manasXP/epicura/docs/02-Hardware/02-Technical-Specifications.md

---
created: 2026-02-15
modified: 2026-02-20
version: 5.0
status: Draft
---

# Technical Specifications

## 1. Heating System

### 1.1 Induction Heater (Microwave Surface Module)

The primary cooking element is a commercial microwave induction surface — a self-contained module with its own power coil, driver electronics, and AC power stage. The module handles all high-voltage power electronics internally and exposes a CAN bus interface for external control. This eliminates the need for custom IGBT driver circuits.

- **Rated Power:** 1,800W maximum
- **AC Input:** 220-240V, 50Hz single-phase (standard Indian household outlet) — connected directly to module
- **Coil Diameter:** 180-220mm (matched to pot base, internal to module)
- **Temperature Range:** 60-250C surface temperature
- **Control:** PID loop at 10Hz on STM32, power commands sent via CAN bus to module
- **Control Interface:** CAN 2.0B at 500 kbps (STM32 FDCAN1)
- **Pot Detection:** Internal to module (won't heat without compatible pot)
- **Internal Safety:** Pot detection, thermal cutoff, overcurrent protection (all module-internal)

### 1.2 Power Level Profiles

| Profile | Power (W) | Temp Range (C) | Use Case | Duty Cycle |
|---|---|---|---|---|
| **Sear** | 1,800 | 200-250 | Browning onions, tempering spices | 100% |
| **Boil** | 1,500 | 100 | Bringing water/gravy to boil | 85% |
| **Simmer** | 400-600 | 80-95 | Slow cooking dal, curry reduction | 25-35% |
| **Warm** | 200 | 60-70 | Keep-warm after cooking complete | 10-15% |
| **Off** | 0 | Ambient | Idle, cool-down | 0% |

### 1.3 PID Control Parameters

- **Setpoint Source:** Recipe state machine (via CM5 command)
- **Feedback:** IR thermometer (primary), CAN coil temperature (secondary/safety)
- **Loop Rate:** 10Hz (100ms period)
- **Output:** Power level command (0-100%) via CAN bus to microwave surface module
- **Overshoot Protection:** Maximum 10C above setpoint triggers power reduction
- **Safety Cutoff:** CAN coil over-temp or IR >270C triggers immediate shutdown

## 2. Sensor Specifications

### 2.1 Camera Module

| Parameter | Value |
|---|---|
| Module | IMX219 (standard) or IMX477 (HQ option) |
| Resolution | 1920x1080 at 30fps (1080p) |
| Interface | MIPI CSI-2 (2-lane) to CM5 |
| Sensor Size | 1/4" (IMX219) or 1/2.3" (IMX477) |
| Field of View | 62.2 (IMX219) or adjustable C/CS mount (IMX477) |
| White Balance | Auto white balance with LED ring compensation |
| Illumination | WS2812B LED ring (12-16 LEDs) or white LED ring with diffuser |
| Mounting | Overhead gantry, 20-30cm above pot center |
| Purpose | Food color/texture analysis, stage detection via CV |

### 2.2 IR Thermometer

| Parameter | Value |
|---|---|
| Part | MLX90614ESF-BAA (medical/food grade) |
| Type | Non-contact infrared thermopile |
| Interface | I2C (address 0x5A default), connected to STM32 |
| Object Temp Range | -70C to +380C |
| Accuracy | +/-0.5C (0-50C ambient), +/-1.0C (full range) |
| Field of View | 90 (wide FOV variant) |
| Resolution | 0.02C |
| Supply Voltage | 3.3V |
| Mounting | Angled toward pot center, 5-10cm distance |
| Purpose | Food surface temperature, PID feedback |

## 3. Data Storage

### 3.1 Storage Architecture

| Storage | Medium | Capacity | Purpose |
|---|---|---|---|
| **eMMC** | On-board CM5 carrier | 8-16 GB | OS, application, recipe DB, cooking logs |
| **SD Card** | MicroSD slot on CM5 | 16-64 GB (optional) | Recipe backup, logs archive, user media |
| **RAM** | LPDDR4 on CM5 | 4-8 GB | Runtime, CV inference, UI frame buffer |

### 3.2 Recipe Database

- **Format:** JSON or YAML per recipe file
- **Recipe Count:** 100+ initial, expandable via OTA
- **Size per Recipe:** ~30-50 KB (steps, temps, timings, images)
- **Total DB Size:** ~5-10 MB initial
- **Storage:** SQLite index + individual recipe files on eMMC
- **Sync:** Cloud download to local, offline fallback guaranteed

### 3.3 Cooking Logs

- **Format:** SQLite database
- **Fields:** Timestamp, recipe ID, step transitions, temperatures (IR + CAN coil), weights, durations, errors, user feedback
- **Retention:** Last 500 cook sessions (~50 MB)
- **Export:** JSON via app or USB

### 3.4 User Preferences

- **Format:** JSON configuration file
- **Contents:** Spice levels, allergens, dietary restrictions, portion sizes, WiFi credentials
- **Backup:** Synced to cloud account when connected

## 4. Power Specifications

| Parameter | Specification |
|---|---|
| **AC Input** | 220-240V, 50Hz, single-phase |
| **Maximum Draw** | <2,000W (1,800W induction + 75W system) |
| **Fuse Rating** | 10A (IEC C14 inlet with integrated fuse) |
| **PSU** | Mean Well LRS-75-24 (24V / 3.2A / 76.8W) |
| **24V Rail** | 24V / 3.2A — main bus from PSU; feeds actuators (12V, 6.5V rails), induction CAN control, safety relay |
| **12V UPS Input** | 12V DC from off-the-shelf UPS — feeds TPS54531 12V→5V 5A buck on Driver PCB |
| **5V Rail** | 5V — three-source Schottky-OR: 5V_MAIN (TPS54531, UPS-backed), 5V_USB (USB-C VBUS), 5V_BATT (MT3608 boost from Li-Ion) → 5V_MERGED → AMS1117 → 3.3V |
| **USB-C Power** | 5V from USB-C VBUS via 500mA polyfuse — enables standalone programming/debug without 24V PSU |
| **Li-Ion Battery** | Single-cell 3.7V Li-Ion (JST-PH 2-pin) — TP4056 CC/CV charger (500mA) + DW01A/FS8205A protection + MT3608 boost to 5V — micro-UPS for STM32 RTC/state retention |
| **3.3V Rail** | 3.3V / 500mA (LDO from 5V_MERGED on Unified PCB) — STM32, sensors, I2C devices |
| **Standby Power** | <5W (CM5 idle, display off, induction off) |
| **PSU Type** | Mean Well enclosed AC-DC, single 24V output |
| **Efficiency** | >87% at full load (Mean Well LRS-75 series) |

### 4.1 12V UPS Recommended Specifications

An off-the-shelf 12V UPS powers the 5V rail (CM5 + STM32) independently of the 24V PSU, allowing the system to detect AC power loss, save cooking state, and gracefully pause.

| Parameter | Minimum | Recommended | Notes |
|---|---|---|---|
| Output Voltage | 12V DC | 12V DC (regulated) | Must be within TPS54531 input range (3.5-28V) |
| Output Current | 3A | 5A | 5V rail peak is ~4A; headroom for inrush |
| Battery Capacity | 7Ah (84Wh) | 9Ah (108Wh) | At ~20W load (CM5 + STM32 + display), 7Ah gives ~25 min runtime |
| Battery Type | Sealed lead-acid (SLA) | Lithium iron phosphate (LiFePO4) | LiFePO4: lighter, longer cycle life, flat discharge curve |
| Charging | Integrated (AC mains) | Integrated with auto-switchover | UPS charges from AC; switches to battery on AC loss |
| Switchover Time | <20ms | <10ms | Must be faster than CM5's hold-up (bulk caps provide ~50ms) |
| Output Connector | Bare wire or barrel jack | XT30 (to match J_12V_UPS) | Adapter cable may be needed |
| Form Factor | — | Compact, <2kg | Must fit inside or adjacent to Epicura enclosure |

**Example products:** Mini DC UPS modules (e.g., "12V 5A UPS module" on AliExpress/Amazon, ~$15-30) that accept 12V AC adapter input, contain a LiFePO4 or Li-ion battery pack, and provide uninterrupted 12V output with automatic switchover.

> [!tip]
> During AC power failure, only the 5V rail (CM5 + STM32 + display) remains powered. The 24V rail (actuators, induction) goes down immediately. The STM32 detects 24V loss via COMP1 comparator (<100µs), disables all actuators, and notifies the CM5 to save state. At ~20W idle draw, a 7Ah 12V battery provides approximately 25 minutes — enough time to save state and wait for power restoration. If power returns within 5 minutes, cooking auto-resumes; otherwise the user is prompted.

### 4.2 Power Budget Breakdown

| Subsystem | Typical (W) | Peak (W) |
|---|---|---|
| Induction heater | 600 | 1,800 |
| CM5 + camera + display | 15 | 25 |
| STM32 + sensors | 2 | 3 |
| BLDC stirring motor | 12 | 48 |
| P-ASD pump + solenoids | 1 | 10 |
| CID-1 stepper driver (24V) | 0 | 72 |
| CID-2 linear actuator (12V) | 0 | 2.5 |
| SLD pumps (x2) + solenoids (x2) | 0 | 16 |
| LED ring | 2 | 5 |
| Exhaust fan | 1 | 3 |
| PSU losses | 10 | 30 |
| **Total** | **644** | **1,927** |

## 5. Performance Requirements

| Parameter | Target | Notes |
|---|---|---|
| CV Inference Latency | <500ms | Food stage classification per frame |
| PID Control Loop | 10Hz (100ms) | Temperature regulation on STM32 |
| Motor Control Loop | 50Hz (20ms) | Servo position updates on STM32 |
| UI Response Time | <200ms | Touch-to-visual feedback on display |
| System Boot Time | <30s | Power-on to recipe selection screen |
| Temperature Accuracy | +/-5C | IR sensor to actual food surface |
| Dispensing Accuracy | ~±20% (P-ASD), ±5% (SLD) | P-ASD by pressure-and-time (ADS1015 feedback), SLD by dedicated per-reservoir load cells (2× 2 kg) |
| Camera Latency | <100ms | Capture to frame available in memory |
| Recipe Step Transition | <2s | From stage detection to actuator response |
| WiFi Connection | <10s | Auto-reconnect to saved network |
| OTA Update | <5 min | Full recipe DB refresh over WiFi |

## 6. Communication Interfaces

| Interface | Protocol | Speed | Endpoints | Purpose |
|---|---|---|---|---|
| CM5 <-> STM32 | UART (primary) | 115200 baud | CM5 UART0 <-> STM32 USART1 | Commands, telemetry, heartbeat |
| CM5 <-> STM32 | CAN (alternative) | 500 kbps | CM5 SPI-CAN <-> STM32 CAN1 | Higher reliability option |
| CM5 <-> Camera | MIPI CSI-2 | 2-lane | CM5 CSI port <-> IMX219/477 | Video frames for CV |
| CM5 <-> Display | DSI or HDMI | 1080p/60Hz | CM5 DSI/HDMI <-> 10" panel | UI rendering |
| CM5 <-> Touch | I2C | 400 kHz | CM5 I2C1 <-> touch controller | Touch input events |
| STM32 <-> IR Sensor | I2C | 100 kHz | STM32 I2C1 <-> MLX90614 | Temperature readings |
| STM32 <-> SLD Load Cells | SPI-like GPIO | 10 Hz | STM32 GPIO <-> 2× HX711 | SLD reservoir weight measurements |
| STM32 <-> BLDC Motor | PWM + GPIO | 10 kHz + digital | STM32 TIM1_CH1 (PA8) + PA4 (EN) + PA5 (DIR) | Stirring motor speed, enable, direction |
| STM32 <-> Microwave Surface | CAN 2.0B | 500 kbps | STM32 FDCAN1 (PB8/PB9) via J_STACK → Driver PCB ISO1050DUB → J_CAN <-> module CAN port | Induction power control via CAN; 5 kV isolation on Driver PCB |
| STM32 <-> Exhaust Fan | PWM | 25 kHz | STM32 TIM4 CH3 <-> fan 4-pin | Fume extraction speed |
| CM5 <-> WiFi | 802.11ac | Up to 867 Mbps | Onboard CM5 radio | App, cloud, OTA |
| CM5 <-> BT | BLE 5.0 | 2 Mbps | Onboard CM5 radio | Initial app pairing, proximity |

## 7. Related Documentation

- [[01-Epicura-Architecture|Hardware Architecture & Wiring Diagrams]]
- [[03-Sensors-Acquisition|Sensors & Data Acquisition]]
- [[04-Mechanical-Design|Mechanical Design]]
- [[../05-Subsystems/05-Exhaust-Fume-Management|Exhaust & Fume Management]]
- [[__Workspaces/Epicura/docs/01-Overview/01-Project-Overview|Project Overview]]

#epicura #technical-specifications #hardware

---

## 8. Revision History

| Version | Date | Author | Changes |
|---|---|---|---|
| 1.0 | 2026-02-15 | Manas Pradhan | Initial document creation |
| 2.0 | 2026-02-16 | Manas Pradhan | Update power budget and dispensing accuracy for P-ASD pneumatic redesign |
| 3.0 | 2026-02-20 | Manas Pradhan | Updated CAN interface row: transceiver (ISO1050DUB) now on Driver PCB, FDCAN1 signals route via J_STACK pins 19-20 |
| 5.0 | 2026-03-09 | Manas Pradhan | Updated power specifications for 3-source 5V architecture (USB-C + Li-Ion battery + UPS), added USB-C and battery power entries |
| 4.0 | 2026-02-20 | Manas Pradhan | Replaced DS3225 servo with 24V BLDC motor in communication interfaces and power budget; servo PWM row → BLDC PWM+EN+DIR row |
