manasXP/epicura/docs/05-Subsystems/03-Ingredient-Dispensing.md

---
created: 2026-02-15
modified: 2026-03-11
version: 6.0
status: Draft
---

# Ingredient Dispensing System

## 1. Overview

The ingredient dispensing system is divided into three purpose-built subsystems, each optimized for a different ingredient class. Together they surround the cooking pot and are orchestrated by the STM32 controller under commands from the CM5 recipe engine.

| Subsystem | Full Name | Purpose | Actuators | Metering |
|---|---|---|---|---|
| **P-ASD** | Pneumatic Advanced Seasoning Dispenser | Ground/powdered spices (turmeric, chili, cumin, salt, garam masala, coriander) | 6 Solenoid Valves + Micro Diaphragm Pump | Pressure-and-time-based (ADS1015 feedback) |
| **CID** | Coarse Ingredients Dispenser | Pre-cut vegetables, meat, paneer, dal, rice | CID-1: NEMA 23 stepper + ext. driver; CID-2: DC linear actuator (slider mechanism) | Timed/position-based |
| **SLD** | Standard Liquid Dispenser | Oil and water | 2 Peristaltic Pumps + 2 Solenoid Valves + 2 Load Cells (one per reservoir) | Closed-loop weight feedback + low-level alerts |

## 2. Layout

### 2.1 Top-View Arrangement

```
┌───────────────────────────────────────────────────────┐
│                    REAR OF UNIT                        │
│                                                        │
│       ┌──────────────────────────────────────────┐     │
│       │        P-ASD (Pneumatic Seasonings)       │     │
│       │  ┌────────┐ ┌────────┐ ┌────────┐        │     │
│       │  │P-ASD-1 │ │P-ASD-2 │ │P-ASD-3 │ Row A  │     │
│       │  │Turmeric│ │ Chili  │ │ Cumin  │ (rear) │     │
│       │  │(60 mL) │ │(60 mL) │ │(60 mL) │        │     │
│       │  └───┬────┘ └───┬────┘ └───┬────┘        │     │
│       │  ┌───┴────┐ ┌───┴────┐ ┌───┴────┐        │     │
│       │  │P-ASD-4 │ │P-ASD-5 │ │P-ASD-6 │ Row B  │     │
│       │  │  Salt  │ │ Garam  │ │Coriand.│ (front)│     │
│       │  │(60 mL) │ │ Masala │ │(60 mL) │        │     │
│       │  └───┬────┘ └───┬────┘ └───┬────┘        │     │
│       └──────┼──────────┼──────────┼──────────────┘     │
│              ▼          ▼          ▼                    │
│  ┌─────┐ ┌──────────────────────────────────┐ ┌─────┐ │
│  │ SLD │ │                                  │ │ SLD │ │
│  │Oil  │ │          COOKING POT             │ │Water│ │
│  │Pump │►│          (Center)                │◄│Pump │ │
│  │     │ │                                  │ │     │ │
│  └─────┘ └──────────────────────────────────┘ └─────┘ │
│              ▲                       ▲                  │
│       ┌──────┴───────────────────────┴─────────┐       │
│       │           CID (Coarse)                 │       │
│       │  ┌──────────────┐  ┌──────────────┐    │       │
│       │  │    CID-1     │  │    CID-2     │    │       │
│       │  │  Vegetables  │  │  Dal / Rice  │    │       │
│       │  │ / Meat (400mL│  │  / Paneer    │    │       │
│       │  │  tray)       │  │  (400mL tray)│    │       │
│       │  └──────────────┘  └──────────────┘    │       │
│       └────────────────────────────────────────┘       │
│                    FRONT OF UNIT                        │
└───────────────────────────────────────────────────────┘
```

### 2.2 Side-View Cross Sections

**P-ASD (Pneumatic Puff-Dosing):**

```
              ┌──── Threaded cap + silicone O-ring seal
              │     ┌── Desiccant pocket (1g silica gel)
              ▼     ▼
       ┌───────────────────┐
       │  ╔═══════════════╗│
       │  ║               ║│  45 mm dia × 50 mm tall
       │  ║   SPICE       ║│  60 mL capacity
       │  ║   POWDER      ║│  Food-grade PP, translucent
       │  ║               ║│
       │  ╚═══╤═══════╤═══╝│
       │      │  AIR ► │    │ ◄── Air inlet barb (4mm, side wall)
       │      └───┬───┘    │
       │     ┌────▼────┐   │
       │     │ 5mm     │   │ ◄── Discharge orifice + 200-mesh SS screen
       │     │ orifice │   │
       │     └────┬────┘   │
       └──────────┼────────┘
                  │
           ┌──────▼──────┐
           │  Bayonet    │ ◄── Quarter-turn lock into docking station
           │  collar     │
           └──────┬──────┘
                  │
           ┌──────▼──────┐
           │ Chute /     │ ◄── Shared collection funnel
           │ Funnel      │
           └──────┬──────┘
                  ▼
       ┌────────────────────┐
       │    COOKING POT     │
       └────────────────────┘
```

**CID (Stepper/Linear Actuator Slider):**

```
       ┌──────────────────────────────────────┐
       │          TRAY (removable)            │
       │  ┌──────────────────────────┐        │
       │  │  Pre-cut ingredients     │  PUSH  │
       │  │  (vegetables, dal, etc.) │◄──PLATE│
       │  └──────────────┬───────────┘   │    │
       │                 │               │    │
       │                 ▼             ──┤    │
       │           ┌──────────┐     Linear    │
       │           │  Drop-off│     Actuator  │
       │           │  Edge    │     (12V DC)  │
       │           └─────┬────┘               │
       └─────────────────┼────────────────────┘
                         ▼
                ┌────────────────────┐
                │    COOKING POT     │
                └────────────────────┘
```

**SLD (Peristaltic Pump + Solenoid):**

```
    ┌──────────────┐
    │  Reservoir   │
    │  (Oil/Water) │
    │  500 mL      │
    └──────┬───────┘
           │ Silicone tube (6mm ID)
           ▼
    ┌──────────────┐
    │  Peristaltic │ ◄── 12V DC gear motor, PWM speed control
    │  Pump        │     Flow rate: 5-50 mL/min
    └──────┬───────┘
           │
           ▼
    ┌──────────────┐
    │  Solenoid    │ ◄── 12V NC solenoid, prevents drip when idle
    │  Valve       │
    └──────┬───────┘
           │
           ▼
    ┌──────────────┐
    │  Nozzle      │ ──► Into cooking pot
    └──────────────┘

    ┌──────────────┐  ┌──────────────┐
    │  Load Cell   │  │  Load Cell   │ ◄── 2× dedicated HX711 (one per reservoir)
    │  (under oil  │  │  (under water│     Closed-loop: pump until target Δweight
    │   reservoir) │  │   reservoir) │     Low-level alert when < threshold
    └──────────────┘  └──────────────┘
```

## 3. P-ASD — Pneumatic Advanced Seasoning Dispenser

### 3.1 Mechanism Overview

The P-ASD uses **puff-dosing** — a micro diaphragm pump pressurizes a small accumulator to ~1.0 bar. Individual solenoid valves open briefly (100–400 ms), delivering calibrated air bursts into sealed cartridges. The pressure forces powder through a 5 mm bottom orifice into a shared funnel chute leading to the pot. This eliminates all moving parts from the powder path, dramatically improving reliability with sticky Indian spices like turmeric and chili.

### 3.2 Cartridge Specifications

| Parameter | Value |
|---|---|
| Cartridges | 6 (P-ASD-1 through P-ASD-6) |
| Capacity | 60 mL each |
| Dimensions | 45 mm diameter × 50 mm tall (cylindrical) |
| Material | Food-grade polypropylene (PP), translucent |
| Removable | Yes (quarter-turn bayonet lock for quick swap) |
| Lid | Threaded screw-cap with silicone O-ring seal, desiccant pocket |
| Orifice | 5 mm diameter bottom opening with 200-mesh SS anti-clog screen |
| Air Inlet | 4 mm barb on side wall (above powder line), self-sealing push-fit |
| Weight (empty) | ~25 g |

### 3.3 Default Cartridge Assignment

| Cartridge | Position | Default Spice |
|---|---|---|
| P-ASD-1 | Row A, Left | Turmeric powder |
| P-ASD-2 | Row A, Center | Chili powder |
| P-ASD-3 | Row A, Right | Cumin powder |
| P-ASD-4 | Row B, Left | Salt (fine) |
| P-ASD-5 | Row B, Center | Garam masala |
| P-ASD-6 | Row B, Right | Coriander powder |

### 3.4 Pneumatic System

#### 3.4.1 Air Source

| Parameter | Value |
|---|---|
| Type | 12V micro diaphragm pump (e.g., SC3701PM or equivalent) |
| Max Pressure | 2.0 bar (200 kPa) |
| Free Flow | 3–4 L/min |
| Voltage | 12V DC |
| Current | 0.5–0.8 A |
| Noise | <45 dB |
| Size | 65 × 40 × 40 mm |

#### 3.4.2 Accumulator & Regulation

| Component | Specification |
|---|---|
| Accumulator | 100 mL sealed aluminum cylinder, 1.5 bar max |
| Pressure Regulator | Miniature inline, adjustable 0.3–2.0 bar |
| Pressure Sensor | ADS1015 (I2C) + MPXV5100GP analog, on I2C1 bus (address 0x48) |
| Relief Valve | 2.0 bar pop-off safety valve on accumulator |
| Operating Pressure | 0.8–1.2 bar nominal |

#### 3.4.3 Solenoid Valves (×6)

| Parameter | Value |
|---|---|
| Type | 2-way normally-closed, direct-acting, 12V DC |
| Response Time | <20 ms open, <30 ms close |
| Orifice | 2–3 mm (sufficient for air burst) |
| Power | ~4W when energized (one at a time) |
| Driver | IRLML6344 N-MOSFET (SOT-23) with flyback diode on Driver PCB |
| Cost | ~$3.50 each |

#### 3.4.4 Pneumatic Circuit

```
12V ───► Micro Diaphragm Pump (3-4 L/min, <45 dB)
              │
              ▼
         Accumulator (100 mL, 1.5 bar max)
              │
              ▼
         Pressure Regulator (set 1.0 bar) + Relief Valve (2.0 bar)
              │
              ▼
         Pressure Sensor ──► STM32 via I2C1 (ADS1015 @ 0x48)
              │
              ▼
         ┌─── 6-Way Manifold (3D-printed nylon PA12) ───┐
         │                                               │
    ┌──┐ ┌──┐ ┌──┐ ┌──┐ ┌──┐ ┌──┐
    │V1│ │V2│ │V3│ │V4│ │V5│ │V6│   6× 12V NC solenoid valves
    └┬─┘ └┬─┘ └┬─┘ └┬─┘ └┬─┘ └┬─┘
     ▼    ▼    ▼    ▼    ▼    ▼
   C-1  C-2  C-3  C-4  C-5  C-6     Cartridges
```

### 3.5 Anti-Clog Design

Pneumatic dispensing inherently prevents clogging — the primary failure mode of gravity-fed systems:

| Advantage | Mechanism |
|---|---|
| Bridge breaking | Pressurized air shatters powder arches over the orifice |
| Humidity tolerance | Forced airflow pushes damp/sticky powder through |
| No residue buildup | No gate in powder path; orifice air-cleared after every dispense |
| Self-clearing nozzle | Post-dispense purge (200 ms at 1.2 bar) cleans orifice |
| 200-mesh SS screen | Prevents large clumps from blocking the 5 mm orifice |
| 60° cone angle | Internal cartridge geometry prevents dead zones |

**Clog Recovery (if no pressure drop after 3 pulses):** Rapid 50 ms on/off oscillating air pulses to vibrate powder loose — pneumatic equivalent of vibration motors, but with no additional hardware.

### 3.6 Metering Strategy

P-ASD uses **calibrated puff-dosing with pressure-drop verification**:

**Primary control:** Timed air pulses calibrated per spice type:

| Spice | Bulk Density (g/mL) | Pulse Duration for ~1g (ms) | Pressure (bar) |
|---|---|---|---|
| Turmeric powder | 0.55 | 200–300 | 1.0 |
| Chili powder | 0.45 | 250–350 | 1.0 |
| Cumin powder | 0.40 | 300–400 | 1.0 |
| Salt (fine) | 1.20 | 100–150 | 0.8 |
| Garam masala | 0.50 | 200–300 | 1.0 |
| Coriander powder | 0.35 | 300–400 | 1.0 |

**Secondary control (pressure-drop verification):** ADS1015 pressure sensor confirms powder ejection:

1. Record pre-dispense accumulator pressure via ADS1015 → P_initial
2. Pre-purge: 100 ms pulse at 0.3 bar (loosen packed powder)
3. Main dispense: open solenoid for calibrated duration
4. Read post-pulse pressure → P_final; verify pressure drop ≥ threshold (confirms air flowed through powder bed)
5. If pressure drop < threshold → additional 50 ms pulses (up to 3 retries)
6. Post-dispense purge: 200 ms at 1.2 bar (clear orifice)
7. Log estimated dispensed amount (pulse count × calibrated mass per pulse)

Accuracy: ~±20% of target weight (pressure-and-time-based, no direct weight feedback).

## 4. CID — Coarse Ingredients Dispenser

### 4.1 Tray Specifications

| Parameter | Value |
|---|---|
| Trays | 2 (CID-1, CID-2) |
| Capacity | 400 mL each (shallow tray, ~200×100×20 mm) |
| Material | Food-grade PP (removable, dishwasher-safe) |
| Removable | Yes (slide-out tray) |
| Ingredient Types | Pre-cut vegetables, meat, paneer, dal, rice |

### 4.2 Actuators

**CID-1: NEMA 23 Stepper Motor + External Driver**

| Parameter | Value |
|---|---|
| Motor | NEMA 23, 1.8°/step (200 steps/rev), ~2A/phase |
| Driver | External DM542/TB6600-class (pulse/dir/enable, 24V input) |
| Control | TIM1_CH3 (PA10) PUL+, GPIO (PB4) DIR+, PCF8574 P7 ENA+ — all via 100R series resistors |
| Position Feedback | Home limit switch only (PB6); step counting for travel distance |
| Supply | 24V from input rail via J_CID (2–3A to external driver) |
| Cost | ~$15 (motor) + ~$10 (driver) |

**CID-2: 12V DC Linear Actuator (unchanged)**

| Parameter | Value |
|---|---|
| Type | 12V DC linear actuator, 50 mm stroke |
| Force | 20–50 N (sufficient to push 500g of chopped vegetables) |
| Speed | ~10 mm/s |
| Control | H-bridge motor driver (DRV8876RGTR #2), EN/PH direction + PWM |
| Position Feedback | Limit switches at home and full-extend positions |
| Supply | 12V from PSU rail |
| Cost | ~$8 |

### 4.3 Dispensing Mechanism

The push-plate slides along the tray, sweeping ingredients off the drop-off edge into the pot:

1. CM5 sends CID dispense command with tray ID
2. STM32 drives actuator forward: CID-1 via stepper pulses (TIM1_CH3), CID-2 via DRV8876 PWM
3. Ingredients fall off tray edge into pot
4. CID-1: step count reaches travel target → reverse to home; CID-2: full-extend limit switch → retract to home
5. Dispense confirmed by home switch

### 4.4 Metering Strategy

CID uses **position-based / timed dispensing**:

- Full push = entire tray contents dumped at once (typical usage)
- Partial push = actuator extends to a specified position (for partial dispense)
- No closed-loop weight verification (coarse items are pre-measured by user when loading tray)

## 5. SLD — Standard Liquid Dispenser

### 5.1 Channel Specifications

| Parameter | Oil Channel (SLD-OIL) | Water Channel (SLD-WATER) |
|---|---|---|
| Reservoir | 200 mL food-grade PP bottle | 500 mL food-grade PP bottle |
| Tube | 6 mm ID food-grade silicone | 6 mm ID food-grade silicone |
| Pump | 12V DC peristaltic, 5–50 mL/min | 12V DC peristaltic, 5–50 mL/min |
| Valve | 12V NC solenoid (drip prevention) | 12V NC solenoid (drip prevention) |
| Nozzle | Directed into pot center | Directed into pot center |

### 5.2 Actuators

**Peristaltic Pump (×2):**

| Parameter | Value |
|---|---|
| Type | Peristaltic roller pump, 12V DC gear motor |
| Tube | Food-grade silicone, 6 mm ID |
| Flow Rate | 5–50 mL/min (adjustable via PWM motor speed) |
| Accuracy | ±2% volumetric (further refined by load cell) |
| Advantage | Self-priming, no contamination (fluid only touches tube), reversible |
| Cost | ~$10 each |

**Solenoid Valve (×2):**

| Parameter | Value |
|---|---|
| Type | 12V DC, normally closed, spring return |
| Response | <50 ms open/close |
| Purpose | Prevent dripping when pump is off |
| Power | ~5W when energized |
| Driver | N-channel MOSFET (IRLZ44N) with flyback diode |
| Cost | ~$4 each |

### 5.3 Dedicated Load Cells (2×)

| Parameter | Value |
|---|---|
| Type | 2× 2 kg strain gauge (one under each SLD reservoir: oil and water) |
| ADC | 2× dedicated HX711 |
| Purpose | Individual liquid level monitoring + closed-loop dispensing by tracking reservoir weight decrease |
| Capacity | 2 kg per load cell (accommodates full reservoir + container weight) |
| Accuracy | ±1 g (24-bit HX711 with averaging) |
| Sampling | 10 Hz |
| Low-Level Alert | Configurable threshold per channel (default: 50 g remaining); alert sent to CM5 + UI when level drops below threshold |
| Cost | ~$5 (load cell) × 2 + ~$3 (HX711) × 2 = ~$16 total |

### 5.4 Metering Strategy (Closed-Loop)

SLD uses **two dedicated load cells** (one under each reservoir) for independent closed-loop dispensing and level monitoring:

```
┌───────────────┐
│ 1. Tare       │
│ reservoir     │──► W_initial = sld_load_cell[channel].read()
│ weight        │
└───────┬───────┘
        │
        ▼
┌───────────────┐
│ 2. Open       │
│ solenoid +    │──► solenoid[channel].open()
│ start pump    │    pump[channel].start(speed)
└───────┬───────┘
        │
        ▼
┌───────────────┐
│ 3. Monitor    │
│ reservoir     │──► W_dispensed = W_initial - sld_load_cell[channel].read()
│ weight loss   │    (sampled at 10 Hz)
│ in real-time  │
└───────┬───────┘
        │
        ▼
┌───────────────┐
│ 4. Stop pump  │
│ + close       │──► IF W_dispensed >= target_g * 0.95:
│ solenoid when │        pump[channel].stop()
│ target reached│        solenoid[channel].close()
└───────┬───────┘
        │
        ▼
┌───────────────┐
│ 5. Verify     │
│ final weight  │──► W_actual = W_initial - sld_load_cell[channel].read()
│ and log       │    log(channel, target_g, W_actual)
│               │    IF sld_load_cell[channel].read() < LOW_LEVEL_THRESHOLD:
│               │        send SLD_LOW_LEVEL alert to CM5
└───────────────┘
```

Accuracy: ±5% of target weight (significantly better than ASD due to dedicated load cell and controllable flow rate).

## 6. STM32 Control Interface

### 6.1 GPIO and PWM Assignments

| Subsystem | Actuator | STM32 Pin | Interface | Notes |
|---|---|---|---|---|
| **P-ASD** | Diaphragm Pump Motor | PA0 (TIM2_CH1) | PWM | 12V pump speed control via MOSFET |
| **P-ASD** | Solenoid Valves V1-V6 | PCF8574 P0-P5 (I2C1, addr 0x20) | Digital output via MOSFET | 12V NC solenoids, cartridges 1-6; PCF8574 on Driver PCB |
| **P-ASD** | Pressure Sensor | I2C1 (PA15/PB7) | I2C via ADS1015 | Accumulator pressure, addr 0x48 |
| **CID** | CID-1 Stepper PUL+ | PA10 (TIM1_CH3) | PWM (200 Hz–10 kHz) | Step pulse to external driver via 100R |
| **CID** | CID-1 Stepper DIR+ | PB4 (GPIO) | Digital output | Direction to external driver via 100R |
| **CID** | CID-1 Stepper ENA+ | PCF8574 P7 (I2C1, addr 0x20) | Digital output via I2C | Enable to external driver via 100R |
| **CID** | Linear Actuator CID-2 EN | PB5 (GPIO) | PWM/GPIO | DRV8876 #2 enable/speed |
| **CID** | Linear Actuator CID-2 PH | PC2 (GPIO) | Digital output | DRV8876 #2 phase/direction |
| **SLD** | Pump Motor SLD-OIL (PWM) | PC3 (GPIO) | PWM (motor speed) | TB6612 PWMA via MOSFET |
| **SLD** | Pump Motor SLD-OIL (DIR) | PC4 (GPIO) | Digital output | TB6612 AIN1 direction |
| **SLD** | Pump Motor SLD-WATER (PWM) | PC5 (GPIO) | PWM (motor speed) | TB6612 PWMB via MOSFET |
| **SLD** | Pump Motor SLD-WATER (DIR) | PC6 (GPIO) | Digital output | TB6612 BIN1 direction |
| **SLD** | Solenoid SLD-OIL | PCF8574 #2 P0 (I2C1, addr 0x21) | Digital output via MOSFET | 12V NC solenoid, flyback diode; moved from PA7 |
| **SLD** | Solenoid SLD-WATER | PCF8574 #2 P1 (I2C1, addr 0x21) | Digital output via MOSFET | 12V NC solenoid, flyback diode; moved from PA9 |
| **SLD** | HX711 #1 SCK (oil) | PC11 (GPIO) | Clock out | SLD oil reservoir load cell (2 kg) |
| **SLD** | HX711 #1 DOUT (oil) | PC12 (GPIO) | Data in | SLD oil reservoir load cell (2 kg) |
| **SLD** | HX711 #2 SCK (water) | PC9 (GPIO) | Clock out | SLD water reservoir load cell (2 kg) |
| **SLD** | HX711 #2 DOUT (water) | PC10 (GPIO) | Data in | SLD water reservoir load cell (2 kg) |

> **Note:** Pin assignments match [[01-Unified-PCB-Design|Unified PCB Design]] document. P-ASD solenoid valves are driven by IRLML6344 MOSFETs on the Unified PCB, with gates controlled by a PCF8574 I2C GPIO expander (addr 0x20) instead of direct STM32 GPIO. PCF8574 #1 P7 is allocated to CID-1 stepper ENA+ (all 8 pins in use: P0-P5 solenoids, P6 CID-2 extend limit, P7 CID-1 stepper enable). A second PCF8574 #2 (addr 0x21) drives SLD solenoids (P0-P1), status LED (P2), and LED ring power (P3), with P4-P7 reserved. I2C1 bus devices: PCF8574 #1 (0x20), PCF8574 #2 (0x21), INA219 (0x40), ADS1015 (0x48), MLX90614 (0x5A). PC0/PC1 are available (pot load cells removed).

### 6.2 Dispensing Command Protocol (CM5 → STM32)

| Command | Code | Parameters | Response | Description |
|---|---|---|---|---|
| DISPENSE_PASD | 0x30 | cartridge_id (1 byte: 1–6), target_weight_g (2 bytes) | ACK + pulse_count + pressure_delta | Dispense seasoning via pneumatic puff-dose, pressure-drop verified by ADS1015 |
| DISPENSE_CID | 0x31 | cid_id (1 byte: 1–2), mode (1 byte: FULL/PARTIAL), position_mm (1 byte) | ACK + status | Push tray contents into pot via linear actuator |
| DISPENSE_SLD | 0x32 | channel (1 byte: OIL=1, WATER=2), target_weight_g (2 bytes) | ACK + actual_weight_g | Pump liquid, closed-loop via dedicated load cell |
| PURGE_PASD | 0x38 | cartridge_id (1 byte: 1–6, or 0xFF=all) | ACK | Post-dispense air purge to clear orifice |
| PRESSURE_STATUS | 0x39 | — | pressure_bar (2 bytes, fixed-point) | Read accumulator pressure |
| QUERY_WEIGHT | 0x35 | source (1 byte: SLD_OIL=1, SLD_WATER=2) | weight_g (4 bytes) | Read weight from individual SLD load cell |
| PREFLIGHT | 0x36 | subsystem_mask (1 byte) | status per subsystem | Check if required subsystems are loaded/ready |
| TARE | 0x37 | source (1 byte: SLD_OIL=1, SLD_WATER=2) | ACK | Zero the specified SLD load cell readings |

## 7. Clog Prevention (P-ASD)

### 7.1 Clog Detection and Recovery Flow

```
┌──────────────┐     ┌───────────────┐     ┌──────────────┐
│ Pre-purge    │────►│ Main dispense │────►│ Pressure     │
│ (100ms,0.3bar│     │ pulse         │     │ Drop         │
└──────────────┘     └───────────────┘     │ Detected?    │
                                           └──────┬───────┘
                                                   │
                                          Yes ◄────┴────► No
                                           │              │
                                           ▼              ▼
                                    ┌──────────┐   ┌──────────────┐
                                    │ Continue │   │ Retry #1:    │
                                    │ Normally │   │ Increase     │
                                    └──────────┘   │ pressure to  │
                                                   │ 1.2 bar,     │
                                                   │ repeat pulse │
                                                   └──────┬───────┘
                                                          │
                                                          ▼
                                                   ┌──────────────┐
                                                   │ Pressure     │
                                                   │ Drop         │
                                                   │ Detected?    │
                                                   └──────┬───────┘
                                                          │
                                                 Yes ◄────┴────► No
                                                  │              │
                                                  ▼              ▼
                                           ┌──────────┐   ┌──────────────┐
                                           │ Continue │   │ Retry #2:    │
                                           │ Normally │   │ Rapid 50ms   │
                                           └──────────┘   │ on/off pulses│
                                                          │ (5 cycles)   │
                                                          └──────┬───────┘
                                                                 │
                                                                 ▼
                                                          ┌──────────────┐
                                                          │ Pressure     │
                                                          │ Drop         │
                                                          │ Detected?    │
                                                          └──────┬───────┘
                                                                 │
                                                        Yes ◄────┴────► No
                                                         │              │
                                                         ▼              ▼
                                                  ┌──────────┐   ┌──────────┐
                                                  │ Continue │   │ CLOG     │
                                                  │ Normally │   │ ERROR    │
                                                  └──────────┘   │ Alert    │
                                                                 │ User     │
                                                                 └──────────┘
```

## 8. Metering Accuracy Summary

| Factor | P-ASD Impact | CID Impact | SLD Impact | Mitigation |
|---|---|---|---|---|
| In-flight material | Powder still in chute after solenoid closes | N/A (push mechanism) | Fluid in tube after pump stops | P-ASD: close at 90% target. SLD: close at 95% target |
| Pressure sensor noise | ±0.02 bar (ADS1015) | N/A | ±1 g (dedicated cell) | Moving average filter (3 samples) |
| Vibration | Minimal (pressure-based, not weight-based) | N/A | Dedicated cell isolated from pot | N/A |
| Sticky ingredients | Pressurized air forces through orifice | Pieces stick to tray | Oil residue in tube | P-ASD: post-dispense purge. CID: angled tray. SLD: tube replacement |
| Fill level variance | Air pressure compensates (consistent regardless of fill) | N/A | Pump rate independent of level | P-ASD: pressure regulation maintains consistent force |

## 9. Recipe Integration

### 9.1 Dispensing Sequence Example (Dal Tadka)

```
Step 1:  DISPENSE_SLD(OIL, 30g)                ──► Oil into hot pot
Step 2:  Wait for sear temp (200°C)             ──► IR sensor confirms
Step 3:  DISPENSE_PASD(P-ASD-1, 3g)             ──► Turmeric powder
Step 4:  DISPENSE_PASD(P-ASD-2, 5g)             ──► Chili powder
Step 5:  Stir briefly                           ──► Arm mixes spices into oil
Step 6:  DISPENSE_CID(CID-1, FULL)             ──► Chopped onions, tomatoes
Step 7:  Wait for browning (CV detection)       ──► Camera detects golden color
Step 8:  DISPENSE_PASD(P-ASD-4, 5g)             ──► Salt
Step 8b: DISPENSE_PASD(P-ASD-5, 3g)             ──► Garam masala
Step 9:  DISPENSE_CID(CID-2, FULL)             ──► Toor dal (200g, pre-measured)
Step 10: DISPENSE_SLD(WATER, 400g)              ──► Water
Step 11: Simmer until done (CV + timer)         ──► Camera detects thickening
```

### 9.2 Ingredient Loading Configuration

Users configure subsystem contents when loading ingredients before cooking:

| Field | Example Value | Source |
|---|---|---|
| Subsystem | P-ASD-2 | Fixed by hardware position |
| Ingredient Name | "Chili Powder" | From recipe ingredient list |
| Target Weight (g) | 5 | From recipe (adjusted for servings) |
| Pre-loaded | Yes/No | User confirms via touchscreen or app |

### 9.3 Pre-Flight Check

Before starting a recipe, the system verifies all required subsystems:

1. **P-ASD:** Short air pulse into each cartridge, monitor pressure drop via ADS1015 — confirms orifice clear and air path unobstructed
2. **CID:** User confirms tray loaded via touchscreen (no automatic check — visual confirmation)
3. **SLD:** Read each reservoir's dedicated load cell — compare oil and water levels individually to minimum required for recipe; alert if either is below threshold
4. Display subsystem status on UI: loaded / insufficient / empty
5. Block recipe start if any required subsystem is insufficient

## 10. Food Safety

### 10.1 Temperature and Hold Time

| Consideration | Guideline | Implementation |
|---|---|---|
| Compartment Temperature | Ambient (no active heating or cooling) | Passive, ingredients at room temperature |
| Maximum Hold Time | 2 hours recommended for perishables | Timer starts when user loads, alert at 90 min |
| Allergen Cross-Contamination | Dedicated subsystems per ingredient type | ASD: dry spices only. CID: separate trays. SLD: separate tubes per liquid |
| Raw Meat Handling | CID-1 designated for raw protein | Tray labeled, separate drop zone, cleaning reminder after use |

### 10.2 Contamination Prevention

- P-ASD: each cartridge has a dedicated discharge path; shared funnel is air-purged between dispenses
- CID: each tray drops into a distinct zone of the pot (no shared surfaces)
- SLD: fluid only contacts silicone tubing (per-channel, no shared path)
- All removable parts are smooth, non-porous food-grade PP
- Silicone pump tubing is replaceable (recommended every 3 months or 200 cycles)

## 11. Cleaning Design

### 11.1 Removable Components

| Component | Removal Method | Dishwasher Safe | Cleaning Frequency |
|---|---|---|---|
| P-ASD Cartridges (×6) | Quarter-turn bayonet, lift out | Yes | After every use |
| P-ASD Cartridge Caps (×6) | Unscrew threaded cap | Yes | After every use |
| P-ASD Orifice Screens (×6) | Press-fit removal from cartridge base | Yes | Weekly deep clean |
| P-ASD Docking Funnels (×6) | Pull out from below | Yes | After every use |
| CID Trays (×2) | Slide out from front | Yes | After every use |
| SLD Reservoirs (×2) | Lift out | Yes | After every use |
| SLD Silicone Tubing (×2) | Disconnect at quick-fit couplings | Hand wash (boil sterilize) | Weekly; replace every 3 months |
| SLD Nozzles (×2) | Unscrew | Yes | After every use |
| P-ASD Pneumatic Tubing | Not user-removable | No | Air purge self-cleans; inspect monthly |
| Linear Actuator / Push-Plate (CID) | Not user-removable | No | Wipe-down weekly |
| Solenoid Valve Assembly (SLD) | Not user-removable | No | Wipe-down weekly |

### 11.2 Auto-Rinse Cycle

For quick cleaning of SLD channels between recipes:

1. User fills SLD-WATER reservoir with warm water
2. Select "Rinse" mode on touchscreen
3. System runs pump through each SLD channel sequentially (water + oil lines)
4. Water flushes through tubing and nozzle into pot
5. User discards pot contents; repeat if needed

## 12. Testing and Validation

### 12.1 Test Procedures

| Test | Subsystem | Method | Pass Criteria |
|---|---|---|---|
| Seasoning Accuracy | P-ASD | 10 trials per cartridge, weigh dispensed amount vs. target | Within ±10% of target weight |
| Liquid Accuracy | SLD | 10 trials per channel, compare load cell reading to scale | Within ±5% of target weight |
| Coarse Dispense | CID | 10 trials, verify full tray contents dumped into pot | All contents reach pot, no spillage |
| Clog Recovery (P-ASD) | P-ASD | Pack powder tightly, run dispense cycle | Cleared within 2 retries, or clean error reported |
| Drip Prevention (SLD) | SLD | After pump stop, observe nozzle for 60s | No drip (solenoid sealed) |
| Cross-Contamination | All | Dispense colored liquid (SLD), colored powder (ASD), inspect adjacent paths | No visible contamination |
| Food Safety Hold Time | All | Load perishable ingredient, monitor temperature over 2 hours | Temperature remains within safe zone (ambient <25°C) |
| Cleaning Verification | All | ATP swab test after cleaning on all removable parts | ATP reading <100 RLU |
| P-ASD Solenoid Endurance | P-ASD | 10,000 open/close cycles per valve | Consistent response time, no leaking |
| P-ASD Pump Endurance | P-ASD | 10,000 pump cycles | Consistent pressure, no membrane degradation |
| SLD Pump Endurance | SLD | 10,000 pump cycles (1-minute runs) | Consistent flow rate, no tube degradation |
| CID Actuator Endurance | CID | 5,000 extend/retract cycles | Limit switches reliable, no mechanical play |
| SLD Solenoid Endurance | SLD | 10,000 open/close cycles | No leaking when closed, consistent response |
| Tubing Replacement | SLD | Replace tubing, verify flow rate matches spec | Flow rate within ±10% of calibrated value |

### 12.2 Prototype Validation Checklist

- [ ] All 6 P-ASD cartridges dock securely via bayonet lock and release easily
- [ ] P-ASD air seals are airtight (no pressure loss when cartridge docked)
- [ ] P-ASD pressure-verified dispensing achieves ~±20% accuracy for all 6 spices
- [ ] P-ASD clog detection fires within 3 pulse cycles of blocked flow
- [ ] P-ASD post-dispense purge clears orifice (no residual powder visible)
- [ ] P-ASD pump recharges accumulator to 1.0 bar within 5 seconds
- [ ] P-ASD pressure sensor reads within ±0.05 bar of reference gauge
- [ ] Both CID trays slide in/out smoothly
- [ ] CID linear actuators push full tray contents into pot reliably
- [ ] CID limit switches trigger at correct positions
- [ ] SLD peristaltic pumps deliver consistent flow at calibrated speed
- [ ] SLD solenoid valves seal completely when de-energized (no drips)
- [ ] SLD oil reservoir load cell reads within ±1g of calibration weight
- [ ] SLD water reservoir load cell reads within ±1g of calibration weight
- [ ] SLD closed-loop dispensing achieves ±5% accuracy (both channels independently)
- [ ] SLD low-level alert triggers when reservoir weight drops below configured threshold
- [ ] Pre-flight check correctly identifies empty/insufficient subsystems
- [ ] All chutes/nozzles direct ingredients into pot center (no spillage)
- [ ] Auto-rinse cycle clears visible residue from SLD tubing

## 13. Related Documentation

- [[__Workspaces/Epicura/docs/01-Overview/01-Project-Overview|Project Overview]]
- [[__Workspaces/Epicura/docs/02-Hardware/02-Technical-Specifications|Technical Specifications]]
- [[01-Epicura-Architecture|Hardware Architecture]]
- [[01-Induction-Heating|Induction Heating System]]
- [[02-Robotic-Arm|Robotic Arm System]]
- [[04-Vision-System|Vision System]]
- [[../06-Compliance/01-Safety-Compliance|Safety & Compliance]]

#epicura #ingredient-dispensing #subsystem #p-asd #pneumatic #cid #sld

---

## 14. Revision History

| Version | Date | Author | Changes |
|---|---|---|---|
| 1.0 | 2026-02-15 | Manas Pradhan | Initial document creation |
| 2.0 | 2026-02-15 | Manas Pradhan | Rewrite: replaced 6-compartment C1-C6 system with 3 subsystems (ASD, CID, SLD) |
| 3.0 | 2026-02-16 | Manas Pradhan | Replaced ASD (servo-gated gravity-fed, 3 hoppers) with P-ASD (pneumatic puff-dosing, 6 cartridges) |
| 4.0 | 2026-02-16 | Manas Pradhan | P-ASD solenoids now controlled via PCF8574 I2C GPIO expander (addr 0x20) on Driver PCB instead of 6× direct STM32 GPIO |
| 5.0 | 2026-03-11 | Manas Pradhan | CID-1: replaced DC linear actuator + DRV8876 #1 with NEMA 23 stepper motor + external driver (PUL/DIR/ENA via PA10, PB4, PCF8574 P7); CID-2 unchanged; updated GPIO table, dispensing mechanism, actuator specs |
| 6.0 | 2026-03-11 | Manas Pradhan | SLD solenoids moved from PA7/PA9 to PCF8574 #2 (0x21) P0/P1 for GPIO headroom; I2C1 bus now 5 devices |
