manasXP/epicura/docs/03-Software/01-Tech-Stack.md

---
created: 2026-02-15
modified: 2026-02-15
version: 1.0
status: Draft
---

# Tech Stack

## 1. Architecture Overview

Epicura uses a dual-processor architecture with clearly separated responsibilities. The CM5 handles high-level application logic and AI, while the STM32G4 manages real-time control and safety-critical operations.

| Layer | CM5 (Application) | STM32G4 (Real-Time) |
|---|---|---|
| **Hardware** | BCM2712, 4x Cortex-A76 @ 2.4 GHz, 4/8 GB RAM | STM32G474RE, Cortex-M4F @ 170 MHz, 512 KB Flash, 128 KB SRAM |
| **OS** | Yocto Linux (Kirkstone/Scarthgap), systemd | FreeRTOS 10.x |
| **UI Framework** | Kivy (Python) on 10" touchscreen | None |
| **AI/ML** | TensorFlow Lite, OpenCV 4.x | None |
| **Application** | Python 3.11+ (Recipe Engine, CV, UI) | C (MISRA C subset) |
| **Communication** | SPI/CAN driver, MQTT, HTTPS | SPI/CAN driver |
| **Storage** | PostgreSQL 16 (Docker), ext4 filesystem | Non-volatile flash (settings, logs) |
| **Development** | Yocto/bitbake, VS Code + Kivy Designer | STM32CubeIDE, STM32CubeMX |

---

## 2. CM5 Software Stack

### 2.1 Hardware Platform

**Raspberry Pi Compute Module 5:**

| Specification | Value |
|---|---|
| SoC | Broadcom BCM2712 |
| CPU | 4-core Cortex-A76 @ 2.4 GHz |
| GPU | VideoCore VII (OpenGL ES 3.1, Vulkan 1.2) |
| RAM | 4 GB LPDDR4X |
| Storage | 64 GB eMMC (onboard) |
| Camera | MIPI CSI-2 (2-lane or 4-lane) |
| Display | MIPI DSI (for touchscreen) or HDMI |
| Connectivity | WiFi 802.11ac, Bluetooth 5.0, GbE |
| GPIO | 28x GPIO, UART, SPI, I2C |
| Carrier Board | CM5IO (Raspberry Pi Compute Module IO Board) |

### 2.2 Operating System & Container Architecture

**Yocto Linux (Kirkstone or Scarthgap LTS):**
- Custom BSP built with bitbake for CM5
- Minimal image (~500 MB): kernel + systemd + Docker daemon
- Device tree overlays for CSI-2 camera and touchscreen
- Read-only rootfs with overlay for data partition
- A/B root partition layout for OTA updates (swupdate)

**Docker Container Architecture:**

All application services run as Docker containers on the CM5:

```
┌─────────────────────────────────────────────────────────────┐
│                  Yocto Linux (Host OS)                      │
│                                                             │
│  ┌───────────────────────────────────────────────────────┐  │
│  │              Docker Engine                             │  │
│  │                                                        │  │
│  │  ┌──────────────┐ ┌──────────────┐ ┌──────────────┐  │  │
│  │  │ PostgreSQL   │ │ MQTT Broker  │ │ Backend API  │  │  │
│  │  │ Container    │ │ (Mosquitto)  │ │ (Fastify)    │  │  │
│  │  └──────────────┘ └──────────────┘ └──────────────┘  │  │
│  │                                                        │  │
│  │  ┌──────────────┐ ┌──────────────┐ ┌──────────────┐  │  │
│  │  │ Frontend UI  │ │ Recipe Engine│ │ CM5-STM32    │  │  │
│  │  │ (Kivy)       │ │ (Python)     │ │ Bridge       │  │  │
│  │  └──────────────┘ └──────────────┘ └──────────────┘  │  │
│  │                                                        │  │
│  │  ┌──────────────┐ ┌──────────────┐ ┌──────────────┐  │  │
│  │  │ CV Pipeline  │ │ Cloud Sync   │ │    Redis     │  │  │
│  │  │(TFLite/OCV/  │ │ Service      │ │  (Queue/     │  │  │
│  │  │ MJPEG:8080)  │ │ (Python)     │ │   Pub/Sub)   │  │  │
│  │  └──────────────┘ └──────────────┘ └──────────────┘  │  │
│  └───────────────────────────────────────────────────────┘  │
└─────────────────────────────────────────────────────────────┘
```

**Container Orchestration:**
- Docker Compose for service management
- Persistent volumes for PostgreSQL data and recipe cache
- Inter-container networking via Docker bridge network
- Host network mode for MQTT and API services

### 2.3 UI Framework

#### 2.3.1 Comparison

| Criteria | Kivy (Chosen) | Qt6/QML | LVGL |
|---|---|---|---|
| Language | Python (pure) | C++ backend, QML frontend | C (pure) |
| Rendering | GPU-accelerated (OpenGL ES) | GPU-accelerated (OpenGL ES) | Software or basic GPU |
| Widgets | Rich set: buttons, sliders, lists, carousel, video | Rich set: buttons, sliders, lists, charts | Lightweight widget set |
| Camera Integration | Kivy Camera widget + GStreamer | Qt Multimedia + GStreamer | Manual framebuffer |
| Touch Support | Native multi-touch, gestures | Native multi-touch, gestures | Basic touch events |
| Python Integration | Native (100% Python) | PySide6 bindings required | ctypes bindings |
| Development Speed | Fast (Python ecosystem) | Moderate (C++ + QML) | Slow (C only) |
| Resource Usage | ~40-60 MB RAM | ~60-100 MB RAM | ~2-10 MB RAM |
| Complexity | Low (single language) | High (C++ + QML + bindings) | Medium (C only) |
| **Recommendation** | **Primary choice** | **Overkill for this use case** | **Too limited** |

**Decision Rationale**: Kivy allows Python developers to build the entire UI without learning QML or managing C++ bindings. Qt6/QML is designed for medical-grade UX and automotive HMIs—overkill for a kitchen appliance. Kivy provides sufficient touch support, GPU acceleration, and camera integration while keeping development simple and aligned with the Python-based backend services.
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
