manasXP/epicura/docs/05-Subsystems/01-Induction-Heating.md

---
created: 2026-02-15
modified: 2026-02-20
version: 3.0
status: Draft
---

# Induction Heating System

## 1. Overview

The induction heating system is the primary thermal element of Epicura, delivering up to 1,800W of cooking power through electromagnetic induction. Epicura uses a **commercial microwave induction surface** — a self-contained module with its own power coil, driver electronics, and AC power stage. The module exposes a **CAN bus interface** for external control, allowing the STM32 controller to set power levels, read status, and receive fault notifications without dealing with high-power IGBT driver circuits directly.

This approach eliminates the need for custom high-voltage power electronics (IGBT half-bridge, gate drivers, resonant tank design, EMI filtering) and leverages a commercially certified, safety-tested heating module.
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
