manasXP/epicura/docs/08-Components/03-Sensor-Components.md

---
created: 2026-02-15
modified: 2026-02-20
version: 2.0
status: Draft
---

# Sensor Components

## 1. Overview

This document details the sensing subsystem components for the Epicura kitchen robot prototype, including the vision camera, infrared thermometer, load cells, temperature sensors, and supporting components.

## 2. Sensor Architecture

```
┌─────────────────────────────────────────────────────────────────┐
│                    Sensor Subsystem                             │
│                                                                 │
│  ┌──────────────┐  CSI-2   ┌──────────────┐                   │
│  │  IMX219      │─────────►│  Raspberry   │                   │
│  │  Camera      │          │  Pi CM5      │                   │
│  └──────────────┘          │  (Vision AI) │                   │
│                            └──────────────┘                   │
│  ┌──────────────┐                                              │
│  │  WS2812B     │◄── GPIO (NeoPixel data line)                │
│  │  LED Ring    │                                              │
│  └──────────────┘                                              │
│                                                                 │
│  ┌──────────────┐  I2C     ┌──────────────┐                   │
│  │  MLX90614    │─────────►│  STM32G474RE │                   │
│  │  IR Thermo   │          │  (Controller)│                   │
│  └──────────────┘          │              │                   │
│                            │              │                   │
│  ┌──────────────┐  GPIO    │              │                   │
│  │  Reed Switch │─────────►│              │                   │
│  │  (Pot Detect)│          └──────────────┘                   │
│  └──────────────┘                                              │
└─────────────────────────────────────────────────────────────────┘
```

---

## 3. Component List

### 3.1 Option A: Standard Camera (Recommended for Prototype)

| Component | Part Number | Qty | Unit Price | Subtotal | Supplier | Notes |
|---|---|-----|---|---|---|---|
| Camera Module IMX219 | RPi Camera Module V2 | 1 | $25.00 | $25.00 | RPi Foundation | 8MP, CSI-2, fixed focus, sufficient for CV |

### 3.2 Option B: Premium Camera (Production Consideration)

| Component | Part Number | Qty | Unit Price | Subtotal | Supplier | Notes |
|---|---|-----|---|---|---|---|
| Camera Module IMX477 | RPi HQ Camera | 1 | $50.00 | $50.00 | RPi Foundation | 12.3MP, C-mount lens, adjustable focus |

### 3.3 Thermal & Weight Sensors

| Component | Part Number | Qty | Unit Price | Subtotal | Supplier | Notes |
|---|---|-----|---|---|---|---|
| IR Thermometer | MLX90614ESF-BAA | 1 | $12.00 | $12.00 | Mouser / DigiKey | Non-contact, I2C, 90° FOV, -70 to +380°C |

### 3.4 Detection & Illumination

| Component | Part Number | Qty | Unit Price | Subtotal | Supplier | Notes |
|---|---|-----|---|---|---|---|
| Reed Switch | MKA-14103 | 1 | $1.00 | $1.00 | Amazon | Pot detection (magnet in pot base) |
| LED Ring (WS2812B) | 12-LED NeoPixel Ring | 1 | $5.00 | $5.00 | Adafruit / Amazon | Camera illumination, consistent lighting |

### 3.5 Passive Components

| Component | Part Number | Qty | Unit Price | Subtotal | Supplier | Notes |
|---|---|-----|---|---|---|---|
| Decoupling Caps (100nF) | 0603, X7R | 5 | $0.10 | $0.50 | Any | I2C/SPI line filtering and bypass |
| Pull-up Resistors (4.7k ohm) | 0603, 1% | 2 | $0.10 | $0.20 | Any | I2C bus pull-ups for MLX90614 |

---

## 4. Cost Summary

### 4.1 With IMX219 (Recommended for Prototype)

| Item | Cost |
|---|---|
| IMX219 Camera | $25.00 |
| MLX90614 IR Thermometer | $12.00 |
| Reed Switch | $1.00 |
| LED Ring (WS2812B) | $5.00 |
| Passive Components | $0.70 |
| **Category Subtotal** | **$43.70** |

### 4.2 With IMX477 (Premium Option)

| Item | Cost |
|---|---|
| IMX477 Camera | $50.00 |
| All other sensors (same) | $18.70 |
| **Category Subtotal** | **$68.70** |

---

## 5. Design Notes

### 5.1 Camera Selection

| Feature | IMX219 (V2) | IMX477 (HQ) |
|---|---|---|
| Resolution | 8 MP (3280x2464) | 12.3 MP (4056x3040) |
| Sensor Size | 1/4" | 1/2.3" |
| Lens | Fixed (integrated) | C-mount (interchangeable) |
| Focus | Fixed (~30 cm to infinity) | Manual focus ring |
| Price | $25 | $50 |
| Prototype Use | Recommended | Overkill |
| Production Use | May suffice | Better for challenging conditions |

**Recommendation:** IMX219 for prototype. Fixed focus simplifies mounting. 8 MP is more than sufficient for food stage classification (model input is typically 224x224 pixels). Consider IMX477 for production if variable focus or better low-light performance is needed.

### 5.2 MLX90614ESF-BAA IR Thermometer
- **90° FOV (BAA variant):** Covers entire pot surface from overhead mounting
- **Temperature range:** -70°C to +380°C (food range: 20°C to 250°C)
- **Accuracy:** ±0.5°C in 0-50°C range, ±2°C at higher temperatures
- **Interface:** I2C (SMBus compatible), default address 0x5A
- **Mounting:** 15-20 cm above pot surface for full pot coverage

---

## 6. Related Documentation

- [[01-Compute-Module-Components|Compute Module Components]]
- [[02-Actuation-Components|Actuation Components]]
- [[__Workspaces/Epicura/docs/08-Components/04-Total-Component-Cost|Total Component Cost]]
- [[__Workspaces/Epicura/docs/02-Hardware/02-Technical-Specifications|Technical Specifications]]

---

#epicura #components #sensors #bom

---

## 7. Revision History

| Version | Date | Author | Changes |
|---|---|---|---|
| 1.0 | 2026-02-15 | Manas Pradhan | Initial document creation |
| 2.0 | 2026-02-20 | Manas Pradhan | Removed NTC thermistors (coil temp via CAN, ambient not needed); subtotal $64.90 → $62.70 |
