manasXP/epicura/Epicura-BOM.xlsx

Sheet: Summary
Epicura PCB Design - BOM Summary
Controller Board
Unique parts: 27
Total components: 49
Est. cost per board: $6.46
Driver Board
Unique parts: 40
Total components: 103
Est. cost per board: $18.54
Combined est. cost: $25.00
PCB Specs: 4-layer, 160x90mm, 1.6mm, 2oz outer Cu, ENIG
Manufacturer: JLCPCB

Sheet: Controller BOM
Ref | Qty | Value | Package | Footprint | LCSC Part# | Description | Unit Price (USD)
U1 | 1 | AMS1117-3.3 | SOT-223 | SOT-223-3_TabPin2 | C6186 | 3.3V LDO 1A | 0.15
U2 | 1 | STM32G474RETx | LQFP-64 | LQFP-64_10x10mm_P0.5mm | C529331 | MCU ARM Cortex-M4 170MHz 512KB | 4.5
Y1 | 1 | 8MHz | HC49-SD | Crystal_SMD_HC49-SD | C12674 | Crystal 8MHz 20pF | 0.12
Y2 | 1 | 32.768kHz | 2012 | Crystal_SMD_2012-2Pin | C32346 | Crystal 32.768kHz 6pF | 0.15
FB1 | 1 | 600R@100MHz | 0603 | L_0603_1608Metric | C1015 | Ferrite bead 600R 0.5A | 0.02
D1 | 1 | Green LED | 0603 | LED_0603_1608Metric | C72043 | LED Green 0603 | 0.02
D2 | 1 | 1N4148WS | SOD-323 | D_SOD-323 | C57759 | Switching diode 100V 150mA | 0.01
Q1,Q2 | 2 | 2N7002 | SOT-23 | SOT-23 | C8545 | N-MOSFET 60V 300mA | 0.02
Q3 | 1 | SI2301CDS | SOT-23 | SOT-23 | C10487 | P-MOSFET -20V -2.3A | 0.04
SW1 | 1 | Reset | TL3342 | SW_SPST_TL3342 | C318884 | Tactile switch 6x6mm | 0.05
C1,C2 | 2 | 10µF 16V | 0805 | C_0805_2012Metric | C15850 | MLCC 10µF 16V X5R | 0.03
C3,C8-C13,C15,C16 | 9 | 100nF 50V | 0402 | C_0402_1005Metric | C1525 | MLCC 100nF 50V X7R | 0.01
C4,C5 | 2 | 18pF 50V | 0402 | C_0402_1005Metric | C1492 | MLCC 18pF 50V C0G | 0.01
C6,C7 | 2 | 6.8pF 50V | 0402 | C_0402_1005Metric | C105594 | MLCC 6.8pF 50V C0G | 0.01
C14 | 1 | 1µF 16V | 0402 | C_0402_1005Metric | C52923 | MLCC 1µF 16V X5R | 0.01
R1,R2 | 2 | 4.7kΩ | 0402 | R_0402_1005Metric | C25900 | Resistor 4.7kΩ 1% | 0.01
R3,R4,R5,R19 | 4 | 10kΩ | 0402 | R_0402_1005Metric | C25744 | Resistor 10kΩ 1% | 0.01
R6,R7 | 2 | 330Ω | 0402 | R_0402_1005Metric | C25104 | Resistor 330Ω 1% | 0.01
R8-R13 | 6 | 33Ω | 0402 | R_0402_1005Metric | C25077 | Resistor 33Ω 1% | 0.01
R17 | 1 | 100Ω | 0402 | R_0402_1005Metric | C25076 | Resistor 100Ω 1% | 0.01
R18 | 1 | 10kΩ | 0402 | R_0402_1005Metric | C25744 | Resistor 10kΩ 1% | 0.01
J1 | 1 | 2x20 Header | 2.54mm | PinHeader_2x20_P2.54mm | C2337 | Pin header 2x20 2.54mm | 0.3
J2 | 1 | JST-SH 4P | 1.0mm | JST_SH_SM04B | C145956 | JST SH 4-pin SMD | 0.15
J3 | 1 | 1x6 Header | 1.27mm | PinHeader_1x06_P1.27mm | C2930929 | Pin header 1x6 1.27mm SWD | 0.1
J4 | 1 | JST-XH 4P | 2.5mm | JST_XH_B4B | C144395 | JST XH 4-pin vertical | 0.08
J5 | 1 | JST-XH 3P | 2.5mm | JST_XH_B3B | C144394 | JST XH 3-pin vertical | 0.07
J6 | 1 | 2x20 Header | 2.54mm | PinHeader_2x20_P2.54mm | C2337 | Stacking header 2x20 2.54mm | 0.3

Sheet: Driver BOM
Ref | Qty | Value | Package | Footprint | LCSC Part# | Description | Unit Price (USD)
U1,U2 | 2 | MP1584EN | SOP-8 | SOIC-8 | C14259 | DC-DC Buck 4.5-28V 3A | 0.45
U9 | 1 | TPS54531DDAR | SOIC-8 | SOIC-8 | C130092 | DC-DC Buck 3.5-28V 5A | 1.2
U4,U5 | 2 | DRV8876RGTR | VSSOP-8 | VSSOP-8_3x3mm | C496057 | H-Bridge motor driver 37V 3.5A | 2.5
U6 | 1 | TB6612FNG | SSOP-24 | SSOP-24_5.3x8.2mm | C88027 | Dual motor driver 15V 1.2A | 1.8
U7 | 1 | INA219BIDR | SOIC-8 | SOIC-8 | C82593 | I2C current/power monitor | 0.9
U8 | 1 | PCF8574T | SOIC-16 | SOIC-16 | C6526 | I2C GPIO expander 8-bit | 0.4
U3 | 1 | ISO1050DUB | SOIC-8 | SOIC-8 | C87591 | Isolated CAN transceiver 5kV | 3.5
Q1-Q11 | 11 | IRLML6344 | SOT-23 | SOT-23 | C152060 | N-MOSFET 30V 5A | 0.05
Q12 | 1 | 2N7002 | SOT-23 | SOT-23 | C8545 | N-MOSFET 60V 300mA | 0.02
F1 | 1 | 5A PTC Fuse | 1206 | R_1206_3216Metric | C70043 | Resettable fuse 30V 5A | 0.15
F2 | 1 | 1.5A PTC | 1206 | R_1206_3216Metric | C70059 | Resettable fuse 16V 1.5A | 0.1
F3,F5 | 2 | 3A PTC | 1206 | R_1206_3216Metric | C70054 | Resettable fuse 16V 3A | 0.12
D1 | 1 | SS54 | SMA | D_SMA | C22452 | Schottky 40V 5A | 0.08
D2 | 1 | SMBJ24A | SMB | D_SMA | C169379 | TVS 24V 600W | 0.12
D3,D20 | 2 | SMBJ12A | SMB | D_SMA | C169376 | TVS 12V 600W | 0.12
D4 | 1 | SMBJ6.5A | SMB | D_SMA | C169373 | TVS 6.5V 600W | 0.12
D17,D18,D19 | 3 | SS34 | SMA | D_SMA | C8678 | Schottky 40V 3A | 0.06
D6-D16 | 11 | SS14 | SOD-123 | D_SOD-123 | C2480 | Schottky 40V 1A | 0.03
L1 | 1 | 33µH 3A | 1210 | L_1210_3225Metric | C408443 | Power inductor 33µH 3A | 0.25
L2 | 1 | 22µH 3A | 1210 | L_1210_3225Metric | C408439 | Power inductor 22µH 3A | 0.22
L4 | 1 | 10µH 5A | 1210 | L_1210_3225Metric | C408435 | Power inductor 10µH 5A | 0.28
R20 | 1 | 10mΩ | 2512 | R_2512_6332Metric | C25330 | Shunt resistor 10mΩ 1W 1% | 0.08
RG1-RG12 | 12 | 100Ω | 0402 | R_0402_1005Metric | C25076 | Resistor 100Ω 1% | 0.01
RPD1-RPD12,R22 | 13 | 10kΩ | 0402 | R_0402_1005Metric | C25744 | Resistor 10kΩ 1% | 0.01
R21 | 1 | 100kΩ | 0402 | R_0402_1005Metric | C25741 | Resistor 100kΩ 1% | 0.01
R23 | 1 | 140kΩ | 0402 | R_0402_1005Metric | C25797 | Resistor 140kΩ 1% | 0.01
R25 | 1 | 71.5kΩ | 0402 | R_0402_1005Metric | C25748 | Resistor 71.5kΩ 1% | 0.01
R27 | 1 | 52.3kΩ | 0402 | R_0402_1005Metric | C25743 | Resistor 52.3kΩ 1% | 0.01
R24,R26,R28 | 3 | 10kΩ | 0402 | R_0402_1005Metric | C25744 | FB divider bottom 10kΩ | 0.01
R29 | 1 | 120Ω | 0402 | R_0402_1005Metric | C25079 | CAN termination 120Ω 1% | 0.01
C17-C21 | 5 | 22µF 25V | 0805 | C_0805_2012Metric | C45783 | MLCC 22µF 25V X5R | 0.05
C22-C25,C27,C28 | 6 | 100nF 50V | 0402 | C_0402_1005Metric | C1525 | MLCC 100nF 50V X7R | 0.01
C26 | 1 | 10µF 16V | 0805 | C_0805_2012Metric | C15850 | MLCC 10µF 16V X5R | 0.03
J1,J2 | 2 | JST-XH 2P | 2.5mm | JST_XH_B2B | C131337 | JST XH 2-pin vertical | 0.06
J3 | 1 | JST-XH 6P | 2.5mm | JST_XH_B6B | C144397 | JST XH 6-pin vertical | 0.1
J4,J5,J6 | 3 | JST-XH 4P | 2.5mm | JST_XH_B4B | C144395 | JST XH 4-pin vertical | 0.08
J7 | 1 | JST-PH 2P | 2.0mm | JST_PH_B2B | C131337 | JST PH 2-pin vertical | 0.05
J8 | 1 | JST-XH 12P | 2.5mm | JST_XH_B12B | C144403 | JST XH 12-pin vertical | 0.18
J9 | 1 | JST-XH 16P | 2.5mm | JST_XH_B16B | C144407 | JST XH 16-pin vertical | 0.22
J10 | 1 | 2x20 Header | 2.54mm | PinHeader_2x20_P2.54mm | C2337 | Stacking header 2x20 2.54mm | 0.3
