manasXP/epicura/docs/02-Hardware/Unified_v1.kicad_pcb

## KiCad design Hardware/2_microcontroller.kicad_sch

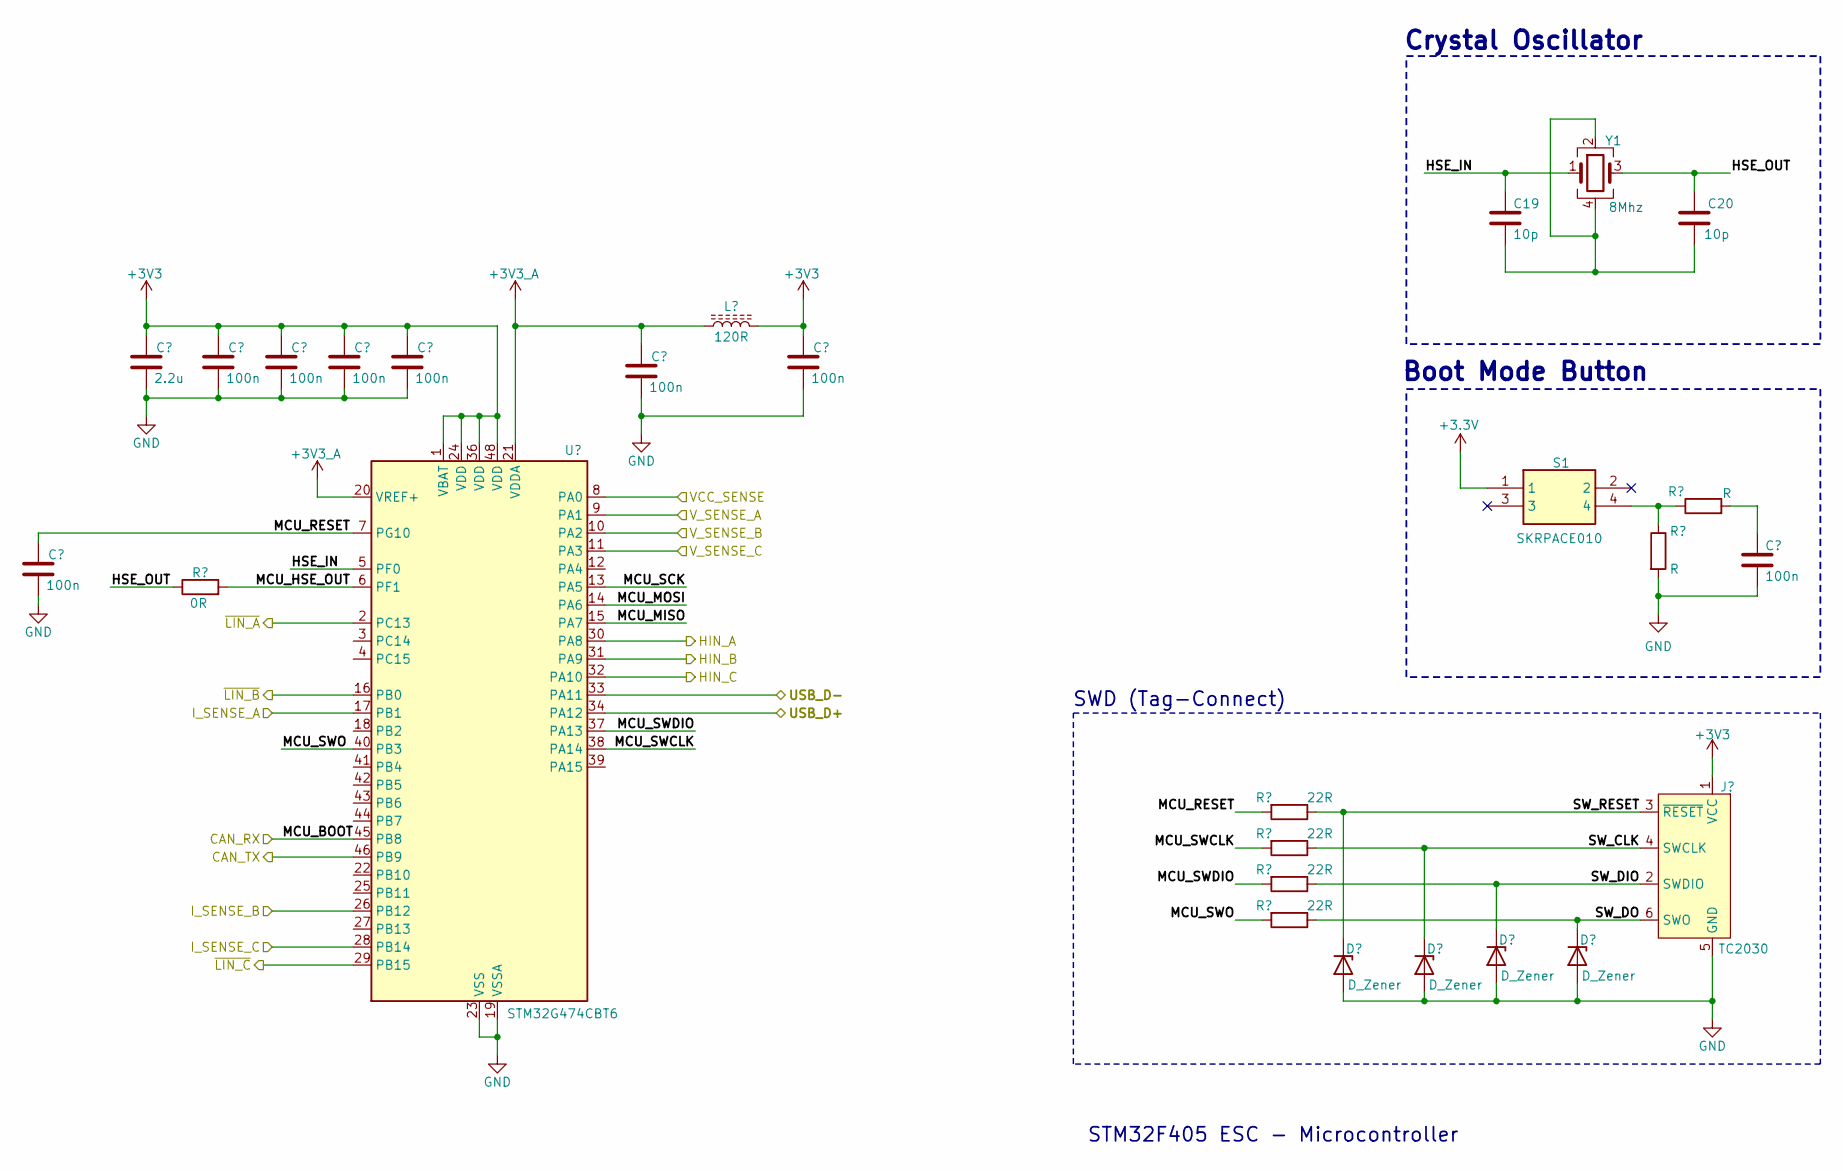
[picture p2: schematic 2_microcontroller.kicad_sch]

Parts:
C19, C20: 10p; C_0402_1005Metric
S1: SKRPACE010; SKRPARE010; Mouser Part Number 688-SKRPARE010
Y1: 8Mhz; Crystal_SMD_3225-4Pin_3.2x2.5mm

Connections:
+3.3V: S1.1
HSE_IN: C19.1, Y1.1
HSE_OUT: C20.1, Y1.3
unnamed: C19.2, C20.2, Y1.2, Y1.4

Notes on the sheet:
STM32F405 ESC - Microcontroller
Crystal Oscillator
Boot Mode Button
SWD (Tag-Connect)
