manasXP/epicura/(commit log)

2026-02-15 Initial commit: Epicura autonomous kitchen robot project
    Add comprehensive project documentation including:
    - Hardware architecture (CM5 + STM32 dual-processor system)
    - Software stack (Yocto, Docker, FreeRTOS, Kivy, Flutter)
    - Subsystem designs (induction, robotics, vision, dispensing)
    - Backend and mobile app architecture
    - PCB designs for controller and driver boards
    - Project management (epics, stories, sprints, procurement)
    - Component BOM and cost analysis
    - Safety compliance and prototype development plan
    This is a design/documentation phase project for a one-pot meal
    cooking robot targeting compact Indian kitchens.
2026-02-16 Replace Qt/QML references with Kivy across all docs
    Kivy (Python) is the chosen UI framework for the touchscreen interface.
    Updated 15 files: replaced Qt6/QML with Kivy in architecture docs, project
    management, UI/UX design, vision system, and prototype plan. Comparison
    tables documenting the Kivy-over-Qt decision are preserved.
2026-02-16 Rename CMIO to CM5IO across all documentation
    Ensures the CM5-specific IO board (CM5IO) is referenced consistently,
    preventing accidental selection of the underpowered CM4IO carrier board.
    58 replacements across 14 files.
2026-02-16 Redesign ASD as pneumatic P-ASD with 6 sealed cartridges
    Replace 3× servo-gated gravity hoppers with pneumatic puff-dosing system:
    1× 12V diaphragm pump, 6× 12V NC solenoid valves, ADS1015 pressure sensor,
    and 6× 60mL sealed cartridges with bayonet docking. Updates pin allocation,
    driver PCB circuits, BOM ($700→$784), MCU firmware spec, and power budget.
2026-02-16 Update documentation for P-ASD pneumatic redesign and component costs
    Updates across hardware architecture, PCB designs, MCU/MPU specs,
    ingredient dispensing, actuation components, procurement schedule,
    and project management docs to reflect pneumatic ASD redesign and
    revised BOM costs.
2026-02-17 Add KiCAD PCB design files and fix controller PCB doc formatting
    [controller-board.kicad_pcb, controller-board.kicad_sch, driver-board.kicad_pcb, driver-board.kicad_sch]
2026-02-17 Add driver board KiCAD PCB files, update to KiCAD 9, CM5IO off-the-shelf
    - Create driver-board KiCAD 9 project: schematic, PCB layout, lib tables
    - Update all PCB files from KiCAD 8 to KiCAD 9.0 (generator version,
    KICAD8_*_DIR → KICAD9_*_DIR env vars)
    - Fix controller schematic parenthesis syntax error (pin 27/28)
    - Update CM5IO Board status to off-the-shelf across all docs
    (was "Custom design required")
    - Update docs: Repository Plan, Architecture, Components, Resource
    Allocation, PCB epic
    [controller-board.kicad_pcb, controller-board.kicad_sch, driver-board.kicad_pcb, driver-board.kicad_sch]
2026-02-17 Add GitHub Project workflow to CLAUDE.md for story tracking
    GitHub Project #3 is now the single source of truth for all story
    status. Includes project/field IDs, status transition commands, and
    rules for moving stories through Todo → In Progress → Done.
2026-02-17 Update KiCAD controller board files and add schematic generator script
    [controller-board.kicad_pcb, controller-board.kicad_sch]
2026-02-17 Route all controller board signal nets with zero shorts
    Complete PCB trace routing for STM32G474 controller board:
    - All 24 signal nets fully connected to J_STACK header
    - 4-layer routing: F.Cu stubs from MCU, B.Cu channel routing to J_STACK
    - Even-column signals thread through 0.84mm J_STACK THT gap
    - Power routing: LDO, CAN transceiver, MCU power vias to inner planes
    - STATUS_LED routed on B.Cu to avoid F.Cu power trace conflicts
    - 107 DRC violations remain (40 topology crossings, 37 clearance,
    16 dangling vias, 13 lib mismatch) — all expected for interactive
    cleanup in KiCAD GUI
    [controller-board.kicad_pcb]
2026-02-17 Fill copper zones and fix remaining shorts
    - Fill GND (In1.Cu) and +3V3 (In2.Cu) power plane zones
    - Move GND bus to y=20 to clear U2 thermal pad
    - Reroute I2C_SCL at y=50 to avoid SPI_SCK/SPI_NSS overlap
    - Result: 0 shorts, 0 unconnected, 92 DRC violations remaining
    (42 topology crossings, 35 clearance, 13 lib mismatch, 2 thermal)
    [controller-board.kicad_pcb]
2026-02-17 Fix driver board KiCad file syntax errors and update design files
    Fix S-expression parsing errors: remove extra generator arg, convert bare
    bold keyword to (bold yes), remove invalid (justify center) clauses.
    [driver-board.kicad_pcb, driver-board.kicad_sch]
2026-02-17 Add UX epic, JSX mock app, Live Activity/Glance stories, and OTP auth endpoints
    - New UX epic (13 epics total) with 8 stories for mobile screen mocks
    - Vite+React mock app in mocks/ with Liquid Glass aesthetic: login, OTP,
    recipe grid, favourites, sessions, profile, mini progress
    - Tab bar updated from Home/Recipes/Cook/Profile to Recipe/Favourite/Session/Profile
    across IOS, AND epics and Mobile Architecture docs
    - Phone+OTP auth endpoints (POST /auth/otp/request, /auth/otp/verify) added to REST API
    - IOS-LIVE.01 (ActivityKit Live Activity) and AND-LIVE.01 (Jetpack Glance widget) stories
    - Updated GitHub Project epic field IDs in CLAUDE.md after UX option addition
    - Driver board schemati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
    [driver-board.kicad_sch]
2026-02-18 Add food preferences section to mobile Profile tab across all docs
    New fields: diet (segmented), preferred cuisines (multi-select chips),
    salt/oil levels (5-point sliders), updated servings default to 2.
    Consistent across UI wireframes, DB schema, REST API, mobile architecture,
    and epic stories (UX, iOS, Android, Backend).
2026-02-20 Add GitHub issue references to PCB, EMB, THR, ARM, CV, RCP, UI epic docs
    Created 49 issues (#97-#145) across all remaining epics and added
    GitHub issue references to every story in all 7 epic docs.
    All issues added to Project #3 with respective epic tags.
2026-02-20 Add 12V UPS-backed power input, power failure detection, LED ring switch, and consolidate P-ASD connector
    Driver PCB (v4.0):
    - Add J_12V_UPS input with TPS54531 12V→5V 5A buck (replaces MP1584EN #3)
    - Add 24V power fail detection via voltage divider + COMP2 on PA1
    - Add POWER_FAIL SPI message (0x14) and power failure state machine
    - Consolidate 7 P-ASD connectors into single J_PASD 16-pin connector
    - Update J_STACK pin 16 to PWR_FAIL, BOM, thermal analysis, block diagram
    Controller PCB (v4.0):
    - Reassign PA1 to COMP2 power fail detection
    - Add LED ring high-side power switch (PA2 → Q2/Q3 P-MOSFET) with J_LED connector
    - Add POWER_TELEMETRY (0x13) and POWER_FAIL (0x14) SPI messages
    - Upd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
2026-02-20 Add 12V UPS recommended specifications to Technical Specifications
    Add UPS spec table (voltage, current, capacity, battery type, switchover
    time) and usage notes. Update 5V rail description to reflect UPS-backed
    TPS54531 source. Include example products and runtime estimates.
2026-02-20 Expand PAUSED state and add RESUMING state to cooking state machine
    PAUSED now reachable from all active cooking states (PREHEATING, DISPENSING,
    COOKING, MONITORING) with five trigger categories: AC power failure, sensor
    malfunction, actuator malfunction, induction cooktop error, and user pause.
    Added RESUMING state between PAUSED and COOKING that ramps the induction
    surface back to the saved target temperature before restoring the cook.
    Includes pause state persistence (PostgreSQL snapshot), resume decision
    logic (auto-resume <5min, prompt 5-30min, ERROR >30min food safety limit),
    and per-trigger detection/auto-resume details.
2026-02-20 Replace non-isolated CAN transceiver with ISO1050DUB isolated transceiver
    The induction module's IGBT switching creates ground bounce and EMI that
    can couple into STM32 logic ground via shared CAN bus ground. ISO1050DUB
    provides 5 kV RMS galvanic isolation meeting IEC 60335 reinforced
    insulation requirements. Updated PCB BOM, power budget, layout rules
    (≥6.4mm creepage), J2 connector (GND→GND_ISO), induction heating block
    diagram, and compute module component list.
2026-02-20 Update total component cost for ISO1050DUB isolated CAN transceiver
    Move CAN transceiver from Actuation ($3.00) to Compute Modules
    (ISO1050DUB $3.50). Update all category subtotals and prototype BOM
    from ~$784 to ~$793.
2026-02-20 Rename connectors to descriptive names and replace J_SPI with J_CM5 stacking receptor
    Rename all Controller PCB connectors from numeric (J1-J11) to
    descriptive: J_CAN, J_IR, J_LC, J_NTC, J_SWD, J_PWR, J_SAFE.
    Remove J3 (servo routes via J_STACK).
    Replace J_SPI (6-pin JST-SH + ribbon cable) with J_CM5 (2x20 pin
    socket) that mates directly with CM5IO 40-pin GPIO header. UPS-backed
    5V now feeds CM5IO through J_CM5 pins 2/4. LED ring data (GPIO18)
    routes through J_CM5 pin 12 as PCB trace instead of jumper wire.
    Also update Actuation Components BOM: move CAN transceiver to Compute
    Modules, replace with termination passives ($0.13).
2026-02-20 Move pot load cell (HX711) from Controller PCB to Driver PCB J_SLD
    Route HX711 signals (PC0/PC1) through J_STACK pins 17-18 to Driver
    PCB instead of separate J_LC connector on Controller PCB. Extend J_SLD
    from 8-pin to 12-pin adding HX711 SCK, DOUT, 3.3V, GND. Load cells
    physically belong near the SLD subsystem, not the Controller PCB.
    Also remove J_PWR (redundant — 5V already comes via J_STACK).
2026-02-20 Remove NTC thermistors and J_NTC connector from Controller PCB
    Coil temperature is already reported by the induction module via CAN
    (HEAT_STATUS). Ambient NTC not needed. Freed PA4/PA5 pins. Removed
    ADC filter circuit (R14-R15, C14-C15), J_NTC connector, and related
    layout rules.
2026-02-20 Move entire CAN subsystem (ISO1050DUB) from Controller PCB to Driver PCB
    FDCAN1 logic signals (PB8/PB9) now route via J_STACK pins 19-20 to the
    Driver PCB where the ISO1050DUB isolated transceiver, decoupling caps,
    termination resistor, and J_CAN connector reside. This keeps all power
    electronics and external wiring on one board and removes isolated copper
    zones from the Controller PCB layout.
    Updated docs: Controller PCB, Driver PCB, Induction Heating, Compute
    Module Components, Actuation Components, Total Component Cost. Net BOM
    impact: zero (components moved between boards/categories).
2026-02-20 Update PCB epic to reflect CAN subsystem move to Driver PCB
    Controller schematic tasks now reference FDCAN1 routing to J_STACK
    instead of on-board CAN transceiver. Driver schematic gains ISO1050DUB
    circuit design task and J_CAN connector. Driver layout adds CAN
    isolation creepage requirement.
2026-02-20 Update architecture doc for CAN subsystem move to Driver PCB
    Updated STM32 pin map, CAN bus wiring diagram, microwave surface
    integration block diagram, safety section, and J_STACK organization
    to reflect ISO1050DUB and J_CAN now residing on the Driver PCB with
    FDCAN1 logic signals routed via J_STACK pins 19-20.
2026-02-20 Merge fan and CID connectors on Driver PCB
    Merged J_FAN1 + J_FAN2 (2× 2-pin) into J_FAN (1× 4-pin JST-XH).
    Merged J_CID_LACT1 + J_CID_LACT2 (2× 2-pin) into J_CID (1× 4-pin
    JST-XH). Reduces total connector count from 12 to 10.
2026-02-20 Update technical specifications CAN interface row for Driver PCB
2026-02-20 Replace DS3225 servo with 24V BLDC motor across all documentation
    BLDC motor (30-50 kg-cm, integrated ESC) replaces DS3225 hobby servo
    for higher torque, continuous rotation, and better thermal handling.
    Key changes: PA8 now 10kHz PWM (was 50Hz), PA4→BLDC_EN, PA5→BLDC_DIR,
    J_SERVO_MAIN→J_BLDC (6-pin), 6.5V rail retained for future use,
    prototype BOM +$10 ($791→$801).
2026-02-21 Add files via upload
    Add controller + driver schematics, BOM
    [Epicura-BOM.xlsx, controller-board.kicad_sch, driver-board.kicad_sch]
2026-02-21 Add PCB design rules document and configure DRC for both boards
    IPC-2221B Class 2 and JLCPCB DFM rules: net classes (Power, SPI, I2C,
    CAN, HighCurrent), track width presets, via dimensions, and tightened
    DRC severities for both controller and driver board projects.
2026-02-21 Add DRC reports for controller and driver boards
    Controller: 100 violations (42 crossing, 35 clearance, 13 lib mismatch).
    Driver: 57 violations (1 short, 25 lib mismatch, 22 missing courtyard).
2026-02-21 Add schematic review report and ignore KiCad lock files
2026-02-21 Add files via upload
    Finalize schematics: 0 ERC errors, subsystem boxes added
    [controller-board.kicad_sch]
2026-02-22 Add files via upload
    All #146 items resolved. ERC: 0 errors.
    Critical fixes:
    - D3 + D4 (PRTR5V0U2X) — ESD protection added on SPI and safety lines
    - SJ1 solder jumper — PB3 IRQ/SWO select added
    - RELAY_COIL+ — connected to +5V rail
    Minor fixes:
    - U1/U2 ref designators corrected (U1=STM32, U2=AMS1117)
    - C14 and PA11 are doc-only updates, will fix in markdown
    [controller-board.kicad_sch]
2026-02-22 Add files via upload
    fix. sorry for the bugs
    [controller-board .kicad_sch]
2026-02-27 Normalize recipe schema and add boot recovery state machine
    - Replace recipe_data JSONB with relational tables: cooking_segments,
    segment_dispensing, and recipe_ingredients with hardware constraints
    (6 ASD boxes, 5 CID slots, 2 SLD types, max 5 segments)
    - Change cuisine varchar to cuisines text[] array on recipes table
    - Update GIN indexes and full-text search vector for new schema
    - Add RECOVERING state to cooking state machine for power loss resume
    - Boot recovery flow queries DB for interrupted sessions, enforces
    30-min food safety cutoff, and ramps surface temp before resuming
    - Bulk documentation updates across all subsystem docs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
2026-03-01 feat(mocks): add Live Activity/Glance widget and Food Preferences mocks
    UX-GLANCE.01: iOS Live Activity (Lock Screen + Dynamic Island compact/expanded)
    and Android Glance Widget (small 2×1, medium 3×2) with cooking/completed/failed
    states and pulsing live indicator.
    UX-PRO.02: Interactive Food Preferences section in ProfileScreen — diet segmented
    control, cuisine multi-select chips, seasoning 5-point sliders, servings stepper.
    Closes #52, Closes #53
2026-03-06 fix(docs): repair all broken wikilinks across 70+ docs
    - Fix sprint links pointing to wrong project (SaaS/Urban.ai → Epicura)
    - Fix wrong file numbers: 07→04 Mechanical Design, 05→03 Sensors,
    09→01 Induction Heating, 10→02 Robotic Arm, 12→04 Vision System,
    13→05 Exhaust Fume Management
    - Fix software file numbers: 04/03→02 Controller Software Architecture,
    08→01 Tech Stack, 03→01 UI-UX Design, 06→01 Safety Compliance
    - Add missing number prefixes: Epicura-Architecture→01, Controller-PCB-Design→01,
    Driver-PCB-Design→02, Prototype-Development-Plan→01
    - Fix non-existent management file refs (01-Epics, 02-Stories, 03-Sprints)
    → correct paths to epics/__i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
2026-03-09 feat(pcb): add USB-C programming port and Li-Ion battery charger to Unified PCB
    Add USB-C port for DFU programming and CDC serial debug using STM32G474RE
    native USB (PA11/PA12). Add Li-Ion battery charger (TP4056+DW01A+FS8205A)
    with MT3608 boost converter for micro-UPS capability. Implement 3-way
    Schottky-OR (5V_MAIN/5V_USB/5V_BATT → 5V_MERGED) enabling standalone
    programming without 24V PSU. Relocate buzzer PWM from PA11 to PB11
    (TIM2_CH4). Board stays 160×90mm at ~31% utilization (+$2.50 BOM).
    Also removes superseded controller-board and driver-board PCB files
    (merged into Unified PCB in prior work) and includes accumulated doc
    updates across multiple subsystem specs.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
    [controller-board .kicad_sch, controller-board.kicad_pcb, controller-board.kicad_sch, driver-board.kicad_pcb, driver-board.kicad_sch]
2026-03-10 fix(pcb): remap I2C1_SCL from PB6 to PA15 per STM32G474RE datasheet
    PB6 has no I2C1_SCL alternate function on the LQFP-64 package
    (DS12288 Rev 6, p.71/74). PA15 (pin 51, AF4) is the correct and
    available pin for I2C1_SCL. Updated all 5 active docs; PB6 is now
    freed as available. PB7 (I2C1_SDA) was already correct.
2026-03-10 fix(pcb): correct 3 pin errors found in datasheet review
    - PA1: COMP2_INP → COMP1_INP (PA1 has COMP1_INP per DS12288 Table 12)
    - Buzzer: PB11/TIM2_CH4 → PC7/TIM8_CH2 (TIM2 frequency conflict —
    exhaust fan 25kHz and buzzer variable tone share same prescaler)
    - Status LED: PC13 → PC8 (PC13 limited to 3mA sink per DS12288 Note 2)
2026-03-11 feat(pcb): add PCF8574 #2 (0x21) I2C GPIO expander for GPIO headroom
    Move 4 non-timing-critical digital outputs to a second PCF8574 at I2C
    address 0x21 (A0=VCC), freeing PA2, PA7, PA9, and PC8 for future use.
    SLD solenoids (P0/P1), status LED (P2), and LED ring enable (P3) now
    driven via I2C; P4-P7 reserved. Combined with existing free pins, the
    STM32 now has 7-8 unassigned GPIO. I2C bus at 5 devices remains within
    400pF budget. +$0.52/unit BOM impact across 6 docs updated.
2026-03-12 refactor(hw): remove pot load cell system, use reed switch for pot detection
    Replace HX711 + 4x strain gauge pot weighing with a simple reed switch
    for pot detection. P-ASD metering changes from weight-based (±10%) to
    pressure-and-time-based (~±20%) via ADS1015. SLD retains its dedicated
    per-reservoir load cells. Updates 15 docs to reflect the simplified
    sensor architecture. Adds STM32G474RE datasheet PDF for reference.
2026-03-13 refactor(hw): merge J_IR and J_LED into single J_IR_LED Hirose DF11-8DP-2DS connector
    Replace two separate connectors (J_IR 4-pin JST-SH + J_LED 3-pin JST-XH) with a
    single J_IR_LED 2x4 Hirose DF11-8DP-2DS dual-row connector, reducing connector
    count from 17 to 16. Pins 1-4 carry IR sensor I2C + power, pins 5-8 carry LED
    ring switched 5V + data + GND + spare.
    [controller-board.kicad_sch]
